10on/xiao-camera-remote/docs/design/ux-redesign.md

> **Repo note (2026-08-27).** This is the **authoritative UI/UX specification**
> for the remote, built from real shooting experience. Where it conflicts with
> the screen handoff (`screen-handoff-readme.md`, `Remote Screen.dc.html`) or
> with the "Профили" model of `filming-remote-requirements-v14.md` §3, **this
> document wins.** What it does *not* change: the handoff's colour system,
> typography, and panel geometry still stand — this document replaces the screen
> *model* and *flow*, not the visual language. Implementation status and the gap
> versus current firmware are tracked in `docs/screen-design.md`.

# Пульт съёмочной техники: UX-спецификация переработки

Статус: черновик требований к новой UX-модели.  
Основание: текущая прошивка и экранная логика `Pult UI Logic`.

## 1. Зачем меняем

Пульт должен быть инструментом для начала съёмки, а не интерфейсом для ручного включения отдельных Bluetooth-устройств. Обычный сценарий выглядит так:

1. Пользователь собирает риг: например, ставит телефон на слайдер и включает оба устройства.
2. Включает пульт.
3. Одним действием выбирает съёмочную конфигурацию либо запускает последнюю.
4. Пульт сам подключает нужные устройства и сразу открывает управление главным устройством.
5. Пользователь двигает слайдер/тележку и запускает или останавливает запись с пульта.

Текущий экран Device List не должен быть стартовой точкой обычной работы. Он полезен для настройки и диагностики, но не для каждого съёмочного дубля.

## 2. Цели и границы

### Цели

- Убрать необходимость вручную включать каждое устройство перед началом съёмки.
- Сделать стартовый путь понятным без чтения подсказок: «выбрал риг → дождался подключения → снимаю».
- Всегда показывать органы управления того устройства, которое сейчас является главным для кадра.
- Оставить телефон вспомогательным устройством записи: он не должен занимать основной экран, пока в конфигурации есть слайдер или тележка.
- Поддержать один или несколько телефонов в одной конфигурации.
- Сохранить безопасность: экстренная остановка должна быть доступна из любого активного экрана.
- Не усложнять сейчас случай нескольких главных устройств; заложить модель так, чтобы его можно было добавить позже.

### Пока не входит в объём

- Одновременное полноценное управление несколькими главными устройствами на одном экране.
- Редактор сложных сценариев/таймлайнов движения.
- Автоматическое определение физически ближайшего устройства без предварительной регистрации.

## 3. Термины и модель

| Термин | Значение |
| --- | --- |
| Устройство | Зарегистрированный BLE-участник: Slider, Dolly, Phone #1, Phone #2 и т. п. |
| Тип устройства | Категория с собственным интерфейсом и набором команд: Motion, Camera/Phone, в будущем Light и др. |
| Главный участник (Main) | Не более одного на первом этапе. Определяет главный экран управления и основной набор команд. Обычно Slider или Dolly. |
| Вспомогательный участник (Secondary) | Устройство, которое участвует в съёмке, но не определяет главный экран. Телефон — типичный пример. |
| Съёмочная конфигурация | Сохранённый набор ролей и устройств: один Main (необязательно) и ноль или больше Secondary. Ранее — «профиль». |
| Быстрый набор | Предустановленная или сохранённая съёмочная конфигурация, доступная на стартовом экране. |
| Сессия | Текущий запущенный набор подключений и его состояние. |
| Дубль (Take) | Период между запуском и остановкой записи; при наличии Main может также запускать/останавливать его движение. |

### Инварианты

- Устройство нельзя одновременно назначить Main и Secondary в одной конфигурации.
- На первом этапе в конфигурации максимум один Main.
- Телефонов может быть несколько, и все они имеют роль Secondary.
- Конфигурация без Main допустима: например, `Два телефона`. В ней открывается простой экран записи.
- Конфигурация с Main, но без телефона, допустима: запись просто недоступна, а пульт управляет движением.
- Незарегистрированные или не входящие в конфигурацию устройства не подключаются во время этой сессии.

## 4. Автоподключение и регистрация

### Обычная работа

После запуска конфигурации пульт сам ищет и подключает только её участников. Пользователь не выбирает Slider, Phone или Dolly по одному и не подтверждает каждое подключение.

На стартовом экране выбранной по умолчанию должна быть последняя использованная конфигурация. Нажатие `OK` запускает её сразу. Остальные популярные конфигурации остаются видны ниже и выбираются стрелками. Это даёт быстрый запуск привычного рига, но не заставляет пульт подключаться к старому набору, если сегодня собрана другая техника.

Отдельная настройка `Автозапуск последней конфигурации` может убрать и это единственное нажатие; по умолчанию она выключена.

### Первый раз и обслуживание

У пульта должен остаться отдельный раздел `Устройства`:

- добавить новое устройство в реестр;
- дать ему понятное имя: `Телефон Дениса`, `Телефон B`, `Слайдер`, `Тележка`;
- увидеть тип, идентификатор и состояние последнего соединения;
- удалить или переименовать устройство;
- проверить соединение вручную.

Это не часть ежедневного сценария. Если устройство уже зарегистрировано и включено, конфигурация подключит его автоматически.

### Ошибки подключения

- Подключение Main важно для основной работы; пока его нет, доступна отмена и экран статуса, но управление движением не имитируется.
- Отсутствующий телефон не должен блокировать управление Main. На экране явно показывается `Запись недоступна: Phone #1 не подключён`.
- При потере Main во время дубля пульт немедленно отправляет аварийную остановку всем ещё доступным Motion-устройствам и завершает состояние дубля.
- При потере телефона во время дубля пульт показывает заметный, но не полноэкранно блокирующий статус; остальные устройства продолжают работать. Если телефон переподключился, он возвращается в сессию.
- Полноэкранное блокирующее сообщение допустимо только при отсутствии или потере Main вне режима дубля.

## 5. Стартовый экран: «Конфигурации»

Это новый домашний экран вместо Device List.

Содержимое:

- заголовок `Конфигурации`, индикатор батареи и общий BLE-статус;
- 3–5 быстрых наборов, прокручиваемых стрелками;
- у каждого набора — название, иконки/краткий состав и последнее состояние;
- первым и выделенным — последний использованный набор;
- внизу постоянные подсказки: `OK — подключить`, `→ — изменить`, `удерживать ← — устройства/настройки`.

Начальные наборы:

| Название | Main | Secondary | Назначение |
| --- | --- | --- | --- |
| Slider + Phone | Slider | Phone #1 | Обычная съёмка телефона на слайдере |
| Dolly + Phone | Dolly | Phone #1 | Съёмка с тележкой |
| Slider | Slider | — | Ручная работа без записи |
| Dolly | Dolly | — | Ручная работа с тележкой |
| Phones | — | Phone #1, Phone #2 | Одновременный запуск/остановка камер |

Наборы — это данные, а не зашитые экраны: пользователь может переименовать, создать копию, изменить состав и удалить пользовательский набор.

## 6. Экран подключения

После `OK` стартовый экран не исчезает мгновенно, а превращается в короткий статус запуска с тем же названием набора.

Для каждого участника показываются состояния: `ищу`, `подключается`, `готов`, `нет связи`. Main отделён визуально от Secondary.

Правила перехода:

- когда Main готов — автоматически открыть экран управления; подключение Secondary продолжается в фоне;
- для набора без Main открыть экран записи, когда готов хотя бы один Phone;
- если за разумный таймаут не готов ни один требуемый участник, оставить экран статуса с действиями `OK — повторить`, `удерживать ← — отменить`;
- повторное открытие конфигурации не должно создавать дублирующие BLE-подключения.

## 7. Главный экран управления

### Общий принцип

Экран строится вокруг Main. То есть `Slider + Phone` выглядит как управление слайдером с компактным блоком записи, а `Dolly + Phone` — как управление тележкой с тем же блоком записи. Пользователь не переключается на экран телефона ради одной команды затвора.

### Общий каркас

- Верхняя строка: имя конфигурации, состояние Main и компактные индикаторы Secondary.
- Центральная часть: модель/параметры Main и его главные действия.
- Нижняя часть: явное действие `REC`/`STOP REC` и короткая подсказка клавиш.
- Проблемы соединения показываются в статусной зоне и не закрывают органы управления без необходимости.

### Slider

На первом экране слайдера должны быть видны минимум:

- выбранная программа слайдера; по умолчанию — `Ping-Pong`;
- подтверждённое слайдером состояние программы: стоит / выполняется / ошибка;
- публичные параметры программы: скорость и стартовая точка;
- явное действие `START / STOP`;
- состояние телефонов: сколько из выбранных камер готово к записи.

Обычный экран не реализует Ping-Pong локальной последовательностью команд направления.
Пульт выбирает, настраивает и запускает готовую программу через Program characteristic,
а состояние отображает только после notify от слайдера. При подключении отправляется
`SELECT Ping-Pong` без перезаписи сохранённых на слайдере параметров.

Ручные `F/B`, абсолютная позиция, ток и homing остаются отдельным экраном
`Advanced / Service`. Перед переходом туда пульт останавливает активную программу. Это
не позволяет случайно смешать состояние preset с ручным jog.

### Dolly

Экран тележки показывает направление, скорость, состояние движения и доступность аварийной остановки. Использует свой набор команд, включая `E-Stop`; у тележки не показывается недоступная команда Home.

### Набор без Main

Для набора из телефонов главный экран — компактная панель камер: сколько подключено, запись идёт/не идёт, таймер дубля и действие `REC`/`STOP`. Никакого пустого «экрана устройства».

## 8. Запись и дубль

### Базовое действие

`OK` на главном экране должно быть однозначно подписано:

- если готов хотя бы один Phone и дубль не идёт — `REC`;
- если дубль идёт — `STOP REC`;
- если телефонов нет или они не готовы — кнопка выполняет основное действие Main только тогда, когда оно явно подписано; она не должна молча начинать движение под видом записи.

При нескольких телефонах `REC` и `STOP REC` рассылаются всем готовым телефонам. Результат показывается по каждому: например, `2/2 REC` или `1/2 REC, Phone B нет связи`.

### Движение во время дубля

Старый неявный жест «OK одновременно включает запись и отправляет MoveForward» заменяется явной политикой дубля в конфигурации:

- `Запись`: `OK` управляет только телефонами;
- `Запись + движение Main`: `OK` запускает запись и выбранную готовую программу Main;
- `Ручное движение`: доступно отдельно в Advanced, независимо от записи.

Для первого релиза конфигурации `Slider + Phone` используется режим `Запись`: `OK`
управляет только записью, а запуск выбранной программы остаётся отдельным явно
подписанным действием `START / STOP`. Комбинированный режим можно включить в параметрах
набора, когда действие `REC + START PING-PONG` явно обозначено на экране.

### Экран/состояние дубля

Во время записи главный экран не заменяется другой логикой полностью. Он сохраняет управление Main, но получает заметный режим дубля: красный REC-индикатор, таймер, число активных камер и доступное действие `STOP REC`.

Долгое `OK` — безусловная аварийная команда: остановить движение Main и отправить `StopRecord` всем подключённым телефонам. Она работает независимо от текущего экрана внутри активной сессии.

## 9. Редактирование конфигурации

Переход: на стартовом экране выбрать набор → `→` → `Изменить`.

Редактор создаёт или меняет конфигурацию последовательными шагами:

1. Название.
2. Main: `нет`, `Slider`, `Dolly`; затем выбор конкретного зарегистрированного экземпляра.
3. Secondary: список зарегистрированных устройств с чекбоксами. Телефонов можно выбрать несколько.
4. Поведение дубля: `Запись` или `Запись + движение Main`.
5. Применить и сохранить.

Если выбран Main, он показывается в сводке отдельно и первым. Список Secondary не должен пытаться навязать пользователю «главное устройство» через порядок строк.

## 10. Навигация и кнопки

Оставляем пять физических кнопок и правило долгого нажатия как возврата/аварийного действия, но делаем их роль предсказуемой по контексту.

| Экран | ↑ / ↓ | ← / → | OK | Удержание OK | Удержание ← |
| --- | --- | --- | --- | --- | --- |
| Конфигурации | выбор | изменить/детали | запустить набор | — | устройства и настройки |
| Подключение | — | — | повторить при ошибке | — | отменить сессию |
| Управление Slider | параметры выбранной программы | параметры выбранной программы | START/STOP или REC/STOP REC согласно явно показанному режиму | E-Stop + StopRecord | выйти к конфигурациям |
| Advanced Slider / Dolly | ручная команда или скорость согласно подсказке | ручная команда или скорость согласно подсказке | подтвердить | E-Stop | назад к программе |
| Управление Phones | — | — | REC / STOP REC | StopRecord | выйти к конфигурациям |
| Редактор | выбор поля | изменить значение/следующий шаг | подтвердить | — | назад без сохранения |

`←` и `→` не обязаны всегда значить одно и то же, но на любом экране должна быть нижняя подсказка. В рабочем экране они никогда не должны случайно открывать меню или менять состав устройств.

## 11. Настройки и технические экраны

Текущие `Brightness` и `OTA update` остаются в настройках. Разделы предлагаются такие:

- `Конфигурации` — создание и изменение быстрых наборов;
- `Устройства` — регистрация, диагностика, переименование;
- `Управление` — биндинг осей, скорости и безопасные настройки;
- `Экран` — яркость, сон;
- `Система` — OTA, версия прошивки.

Старый Device List становится подразделом `Устройства` и диагностическим экраном, а не экраном, на который возвращается каждый `hold ←`.

## 12. Состояния, которые обязаны быть видимы

1. Конфигурация выбрана, но ещё не запущена.
2. Идёт поиск/подключение конкретного устройства.
3. Main готов, Secondary ещё подключаются.
4. Main работает, запись недоступна из-за отсутствующего телефона.
5. Идёт дубль: таймер, камеры, движение Main.
6. Один из нескольких телефонов потерян во время дубля.
7. Main потерян или аварийно остановлен.
8. Конфигурация без Main: камеры только для записи.

Для каждого состояния пользователь должен видеть, что работает сейчас, чего не хватает и какая следующая доступная команда. Сообщения не должны требовать догадки о том, какой именно Bluetooth-статус скрывается за точками или цветом.

## 13. Отложенное расширение: несколько Main

Модель допускает `mainDevices[]`, но интерфейс первого релиза использует только `mainDevice` или `null`. Когда появится второй Main, не следует просто смешивать все кнопки. Нужны отдельные правила: активный Main, объединённый виджет или отдельный режим синхронного дубля. До этого момента редактор не позволяет выбрать больше одного Main.

## 14. Критерии готовности первого релиза

- С выключенного пульта сценарий `Slider + Phone` запускается максимум двумя действиями: включить пульт, нажать `OK` на последнем наборе.
- Пользователь не выбирает отдельные устройства вручную для обычной съёмки.
- После готовности слайдера пульт открывает управление им, не ожидая телефон бесконечно.
- На экране `Slider + Phone` пользователь одновременно видит доступность записи и состояние слайдера.
- `OK` никогда не запускает скрытое движение, если надпись на экране обещает только запись.
- Основной экран Slider управляет готовым Ping-Pong через Program API; `F/B` доступны
  только в явно обозначенном Advanced режиме.
- После BLE write UI не меняет состояние программы сам: `RUNNING`, параметры и ошибки
  подтверждаются Program notify.
- При двух телефонах старт и остановка записи отправляются обоим, а частичный сбой понятен по экрану.
- Долгое `OK` останавливает все доступные Motion-устройства и запись на всех доступных телефонах.
- Пользователь может создать набор без Main и набор без телефона.
- Список устройств, OTA и яркость остаются доступны, но не мешают ежедневному запуску съёмки.

## 15. Решения, которые можно принять позже

- Нужен ли по умолчанию режим `Запись + движение Main` для каких-то конкретных ригов.
- Нужно ли делать автозапуск последней конфигурации включённым по умолчанию после нескольких успешных использований.
- Какие именно данные Slider и Dolly способны отдать для экрана: скорость, направление, позиция, заряд, состояние команды.
- Как именно обозначить связь с конкретными телефонами: пользовательское имя, номер, цвет или иконка.
- Нужен ли быстрый режим временно добавить устройство к текущей сессии без сохранения конфигурации.

---

## Приложение: сведение с остальными документами репозитория (2026-08-27)

Не входит в исходный документ — добавлено при переносе в репозиторий. Исходный
текст выше не менялся.

### Что этот документ заменяет

- **`screen-handoff-readme.md` / `Remote Screen.dc.html`, список из 7 экранов.**
  Домашний экран больше не «Main / device status», а «Конфигурации». Появляются
  новые экраны: подключение, Main-центричное управление, редактор конфигурации,
  реестр устройств. Device List превращается в диагностический подраздел
  `Устройства`. Цвета, типографика и геометрия из handoff остаются в силе —
  меняется модель и поток экранов, не визуальный язык.
- **`filming-remote-requirements-v14.md` §3 «Профили».** Модель
  `Profile { name, devices, bindings[input→targets[]] }` с редактором биндингов
  заменяется ролевой моделью: `Config { name, main?, secondary[], takeMode }`.
  Fan-out одной кнопки (кейс «интервью»: центр = запись + старт слайдера)
  сохраняется, но выражается режимом дубля `Запись + движение Main`, а не
  произвольным массивом `targets`. Биндинг осей (скорость на ↑↓ / ←→) становится
  глобальной настройкой в разделе `Управление`, а не полем профиля.

### Что остаётся из v14 и должно сосуществовать с новым потоком

- Аварийный стоп = долгое нажатие центральной кнопки → широковещательный
  `StopAll` в обход конфигурации (v14 §9). Совпадает с §8/§10 этого документа.
- Watchdog на стороне моторного устройства (~2 сек без команды → само
  останавливается, v14 §9) дополняет pult-side аварийную остановку из §4.
- Deep sleep как дефолтное состояние покоя, «первое нажатие после сна только
  будит, не выполняет команду», суточная проверка заряда (v14 §7) — этот
  документ их не отменяет и не упоминает.
- Индикация записи на телефоне — «команда отправлена», не «идёт запись»
  (v14 §2, HID односторонний). REC-индикатор и таймер из §8 трактуются как
  состояние **дубля** (pult-side период старт→стоп) и статус доставки команды
  (`2/2 REC`), а не как подтверждённый факт съёмки. Копирайт на экране держать
  в этих терминах.

### Технические риски, которые ставит новая модель

- **Несколько телефонов одновременно.** Пульт — BLE HID peripheral; несколько
  телефонов = несколько центральных хостов на одном HID-устройстве. HID-over-GATT
  обычно завязан на один забонженный хост. Проверить на макете до того, как
  `Phones` станет обещанной конфигурацией.
- **Автоподключение только участников конфигурации.** `BleManager` держит один
  общий скан и реконнектит все активные устройства (см. `src/ble_manager.*`);
  «активность» теперь задаёт конфигурация, а не ручной тоггл в Device List.

### Пиксельный мок и статус реализации (2026-08-28)

Полный экранный мок под эти требования — `docs/design/ux-redesign-mock/`
(`new-model.dc.html`, 24 экрана 280×240 в палитре `src/theme.h`). Реализован
целиком на ветке `ux-redesign-rigs` (собирается, на железе не проверялся).
Копирайт — английские заглушки: кириллического `GFXfont` в прошивке нет,
это отдельный заход. Подробная карта «экран мока → код» — в
`docs/screen-design.md`.

Ключевые изменения кода:

- `src/menu.*` разбит: `menu.cpp` (конечный автомат + ввод), `menu_render.cpp`
  (все `render*`), `menu_internal.h` (общие хелперы риг/сессии). Экраны:
  `Rigs, RigMenu, Editor, TextEntry, Connecting, Control, Settings, Devices,
  DeviceCard, Scan, ControlPrefs, ScreenPrefs, System`.
- Неявный комбо-жест `comboModeActive()` удалён — заменён явным `Rig::takeMode`
  (по умолчанию `RecordOnly`).
- `src/profile.{h,cpp}` → `src/rig.{h,cpp}`: `Rig` — мутабельная структура
  (имя, `mainIndex`, `secondary[4]`, `takeMode`). `src/rig_store.*` — NVS-blob
  с версией, сидит дефолты из §5, CRUD для редактора.
- `src/device_table.*` — стабильная нумерация устройств (`deviceAt`/
  `deviceCount`/`deviceIndexOf`), на которую ссылаются риги.
- `src/device_registry.*` — алиас устройства (NVS) + грубый `SeenState`.
- `Device`: `kind()`, `supportsHome()`, `speedPercent()` (1..100%; была пара
  `speedLevel()`/`speedLevelMax()` с шкалой 1..8 — 2026-08-29 перешли на проценты,
  родную единицу слайдера, см. `docs/screen-design.md` строка 4).
- `src/settings.*`: `axisBinding`, `autostartLastRig`, `maxSpeedPercent`,
  `buttonSound`, `factoryReset()`; старые ключи `profile`/`binding` брошены,
  `maxspd` → `maxspdpct`.

Отложено: несколько телефонов (риг `Phones` пока цепляет один); настоящая
регистрация устройства с экрана `Scan` (нужны динамические драйверы);
драйвер столика; отдельный экран батареи; сон в разделе «Экран»; иконки-
пиктограммы устройств (в чипах пока 2-буквенный `abbrev()`).
