10on/xiao-camera-remote/docs/design/requirements-v4.md

# Съёмочный пульт — требования (v4, итоговый черновик)

**Обновлён:** 2026-08-20
**Изменение к v3:** плата защиты аккумулятора (1S DW01A+8205A) заказана — статус закрыт, под неё зарезервировано место в корпусе.

Легенда: ✅ зафиксировано · 🟡 предварительно · ❓ открыто · ⚠️ риск/замечание

---

## 1. Назначение

Компактный автономный BLE-пульт для управления съёмочной техникой во время съёмки. Физический контроллер текущего сетапа, а не touchscreen-remote. Основные операции — вслепую, одной рукой.

✅ Пульт универсальный, не приставка к слайдеру.

---

## 2. Управляемые устройства

| Устройство | Роль | Протокол | Статус |
|---|---|---|---|
| Смартфон | старт/стоп записи | ✅ **BLE HID** — эмуляция BT-кнопки-гарнитуры (как ali-shutter) | решено |
| Самодельный слайдер | движение, старт/стоп, позиции | ✅ свой BLE GATT, протокол дорабатываем под пульт | решено |
| Коммерческая тележка | движение | ✅ **есть официальный API и документация** | решено, риск снят |
| **Предметный столик** | вращение: старт/стоп, скорость, направление, угол/шаг | ✅ **свой протокол** (проектируется вместе с пультом) | заложить в архитектуру |
| Свет | — | — | ❌ **вне скоупа**, вернуться если появятся устройства |

### Предметный столик

✅ Свой протокол — как и у слайдера, значит проектируется под пульт, а не реверсится.

🟡 **Рекомендация: сделать слайдер и столик одним семейством протокола**, а не двумя разными. Оба — «моторизованная ось»: старт/стоп, скорость, направление, позиция, home, лимиты. Разница только в том, что у слайдера ось линейная, а у столика — вращательная и бесконечная (нет концевиков, позиция циклическая).

Что это даёт: один драйвер `MotionAxisDriver` вместо двух, одинаковые команды с пульта, общий код прошивки на обоих устройствах. При добавлении третьей моторизованной штуки (слайдер по второй оси, поворотная голова) — драйвер уже готов.

Что заложить в общий протокол:
- `axis_type`: linear / rotary
- для rotary: позиция в градусах, «бесконечное» вращение как отдельный режим
- у столика типовой сценарий — **непрерывное вращение с заданной скоростью** и **пошаговое вращение** (N градусов на кадр, для покадровой съёмки). Второе стоит заложить сразу.

❓ Есть ли у столика концевик / точка home. Для повторяемых съёмок «начать с той же стороны» это полезно.

### ⚠️ Ключевое следствие: пульт должен быть BLE dual-role

- к **телефону** — как **peripheral** (HID-устройство, телефон видит его как кнопку/гарнитуру);
- к **слайдеру и тележке** — как **central** (пульт сам подключается к ним).

Одновременно. ESP32 это умеет (NimBLE, роли central+peripheral в одном стеке), но это надо заложить в архитектуру с самого начала, а не прикручивать потом. В конфиге NimBLE явно задаются `MAX_CONNECTIONS` и обе роли.

### ⚠️ Ограничение HID-подхода к телефону

Эмуляция кнопки гарнитуры (обычно Volume Up / Enter) — это **односторонняя команда без обратной связи**:

- пульт не знает, идёт ли запись на самом деле;
- работает только если приложение камеры на переднем плане;
- на iPhone поведение отличается от Android.

**Следствие:** светодиод «идёт запись» для телефона показывает **намерение**, а не факт. Либо честно индицировать «команда отправлена», либо в будущем делать приложение-компаньон. ❓ Решить, как это отражать в UI.

### Слайдер

✅ На слайдере есть **две физические кнопки**.
✅ Протокол слайдера **можно дорабатывать** под нужды пульта — это не чужой чёрный ящик.
❓ Арбитраж: что делает слайдер, если команда пришла и с кнопки, и с пульта. Приоритет? Последний победил?

---

## 3. Профили

✅ **Профили нужны** (изменение относительно первой версии требований, где от них отказывались).

Профиль = именованный набор устройств сетапа, который можно быстро выбрать.

Требования:
- создать/переименовать/удалить профиль;
- профиль хранит список устройств (адреса + тип драйвера) и, возможно, их роли/маппинг кнопок;
- быстрое переключение профиля с пульта;
- хранение в NVS (переживает перезагрузку);
- 🟡 3–8 профилей достаточно.

### ✅ Маппинг кнопок хранится в профиле

Решено: **маппинг может отличаться от профиля к профилю**. Профиль — это не просто список устройств, а полная раскладка сетапа.

Структура профиля:

```
Profile {
  name: string
  devices: [ { addr, driver_type, alias } ]
  bindings: [
    { input: Btn.Up | Btn.Down | Btn.Left | Btn.Right | Btn.Center,
      gesture: Short | Long | Double,
      targets: [ { device_idx, command, params } ] }
  ]
}
```

Следствия, которые надо учесть:

- **Один input → массив targets.** Это то, что даёт fan-out: центральная кнопка в профиле «интервью» = запись на телефоне + старт слайдера одновременно.
- **Нужен редактор биндингов.** На экране 240×280 и пятью кнопками редактировать раскладку — мучение. 🟡 Предлагаю: на пульте только выбор из **пресетов раскладки** («слайдер+телефон», «столик+телефон», «только запись»), а произвольное редактирование — позже и не с пульта (веб-морда в OTA-режиме или конфиг-файл).
- **Устройство в профиле может быть офлайн.** Биндинги на него должны деградировать молча, а не ломать профиль.
- **Дефолтные биндинги на тип драйвера.** При добавлении устройства в профиль сразу подставляется разумная раскладка для его типа, дальше правится. Иначе каждый новый профиль надо собирать с нуля.

25 комбинаций (5 кнопок × 3 жеста, минус занятое под навигацию) — этого хватает с запасом.

---

## 4. Органы управления

✅ **5 физических кнопок, крестом (↑ ↓ ← → + центр).**
✅ Центральная кнопка пока такая же, как остальные; возможность переработки (крупнее/другая форма) заложить в корпус, но не делать сейчас.
✅ Microtact на PCB + напечатанные толкатели.
✅ Пригодность к работе вслепую.

### Модификаторы

Раз кнопок всего 5, а устройств 2–3, нужны:
- долгое нажатие;
- двойное нажатие;
- комбинации (например ● + ↑).

⚠️ Комбинации **не работают**, если кнопки повешены на резистивную ADC-лесенку (см. §11). Если комбинации нужны — только расширитель портов или отдельные GPIO.

---

## 5. Индикация

✅ Индицировать нужно **4 состояния**:
1. зарядка
2. идёт запись / активное действие
3. потеря связи с устройством
4. низкий заряд

✅ Реализация: 2–3 обычных светодиода **или RGB**.
✅ Допустимо вешать через расширитель портов (либо на расширитель уходят кнопки, а LED на GPIO).

🟡 **Рекомендация: 1–2 адресных WS2812 вместо дискретных LED.**

Почему: один GPIO вместо трёх, любой цвет и яркость программно, четыре состояния кодируются цветом + миганием, а не количеством диодов. Учитывая дефицит пинов (§11) — это самый дешёвый по пинам вариант. Минус: WS2812 ест ~1 мА даже погашенный, и есть паразитная подсветка корпуса. При двух диодах: один «система» (зарядка/батарея), один «связь/запись».

⚠️ Через PCF8574 **нельзя** сделать плавную яркость — только вкл/выкл. Для RGB на расширителе это значит 7 фиксированных цветов, без затухания.

---

## 6. Дисплей

✅ **Waveshare TFT 1.5" 240×280 IPS**, контроллер ST7789V3, SPI.
✅ Ориентация **горизонтальная**.
✅ **Управление яркостью обязательно** → пин BL должен идти на GPIO с аппаратным PWM (LEDC), **не через расширитель**.

Память: 240×280×16 бит = **131 КБ** на полный кадровый буфер.
- На XIAO ESP32-S3 с PSRAM это некритично.
- Правильнее LVGL с частичными буферами (1/10 экрана ≈ 13 КБ) — тогда хватает и внутренней RAM.
- ✅ Внешние модули памяти есть в наличии, если понадобятся — но, скорее всего, не понадобятся.

---

## 7. Энергосбережение

✅ **Основной механизм — управление яркостью подсветки.**
- при пробуждении подсветка на рабочем уровне;
- после бездействия — гаснет (или уходит в dim);
- BLE-соединения при этом **не рвутся**;
- любая кнопка возвращает подсветку, первое нажатие только будит и **не выполняет команду** ❓ (или всё-таки выполняет? для съёмки может быть критично не терять нажатие).

✅ Deep sleep всего МК **не используется** между командами.
✅ Wi-Fi **выключен по умолчанию**, включается только в отдельных функциях.

---

## 8. Wi-Fi и OTA

✅ Wi-Fi нужен **только под OTA**. Других функций пока нет.
✅ Реализация: **отдельный пункт меню**, который:
1. включает Wi-Fi,
2. переводит пульт в режим ожидания прошивки,
3. показывает на экране статус/IP,
4. по выходу или таймауту гасит Wi-Fi обратно.

✅ **OTA — эксклюзивный режим.** Пока он активен, остальные функции недоступны: BLE отключается, соединения с устройствами рвутся, кнопки работают только на выход из режима. На экране — статус и способ выхода.

Почему это правильно: снимает конкуренцию Wi-Fi и BLE за радио (у ESP32 они делят антенну и время), убирает риск «начали прошивку, а в этот момент кто-то нажал старт слайдера», и упрощает состояние прошивки — не надо поддерживать работу драйверов во время обновления.

❓ Способ доставки: ArduinoOTA / web-uploader / ESP-IDF OTA по HTTP.
🟡 Если делать web-uploader — та же веб-морда пригодится для редактирования профилей и биндингов (§3).

---

## 9. Программная архитектура

✅ Интерфейс пульта не зависит от протокола устройства. Кнопка означает `Record`, `StartMove`, `Stop`; в конкретный пакет это превращает драйвер устройства.

```
[5 кнопок] → [Input/Gestures] → [UI/State] → [Command Bus] ─┬→ [PhoneDriver]  → BLE HID (peripheral)
                                    ↑                       ├→ [SliderDriver] → BLE GATT (central)
                              [ProfileStore/NVS]            └→ [DollyDriver]  → BLE API (central)
```

Требования:
- независимые драйверы на тип устройства;
- список обнаруженных устройств + сохранение известных;
- профили (§3);
- автоматический реконнект;
- отображение состояния соединений;
- fan-out одной команды на несколько устройств.

---

## 10. Корпус

✅ 3D-печатный, компактный, в руке и в кармане, яркий цвет.
✅ **USB-C от XIAO выведен наружу** и служит портом зарядки → плата должна стоять так, чтобы разъём попадал в стенку корпуса (логично — низ).
✅ Толкатели кнопок — часть корпуса.
✅ Зарезервировано место под плату защиты аккумулятора (~30×4 мм, между пакетом и XIAO — физически рядом с батарейным отсеком).
🟡 Габариты порядка 42 × 85–100 × 16–20 мм.
🟡 Аккумуляторы внизу для развесовки.
❓ Крепление: темляк / клипса / липучка.

---

## 11. Аппаратная платформа

### МК

✅ **XIAO ESP32** (4 шт XIAO ESP32-S3 в наличии).
❓ Уточнить вариант: S3, C3 или C6. Рекомендация — **S3**: PSRAM под графику, больше GPIO, и их у тебя 4 штуки.

### ⚠️ Дефицит пинов — главная нерешённая инженерная задача

XIAO ESP32-S3 выводит **11 GPIO (D0–D10)**. Считаем:

| Потребитель | Пинов |
|---|---|
| Дисплей SPI: SCK, MOSI, CS, DC | 4 |
| Дисплей RST | 1 (можно сэкономить — RC-цепочка на питание) |
| Дисплей BL (PWM, обязательно GPIO) | 1 |
| Замер напряжения батареи (ADC + делитель) | 1 |
| 5 кнопок | 5 |
| Индикация | 1 (WS2812) или 3 (дискретные LED) |
| **Итого без расширителя** | **13–15 → не влезает** |

Варианты решения:

**A. PCF8574 на кнопки** (он уже есть, использовался в слайдере)
`SDA + SCL + INT = 3 пина` дают 8 входов.
Итого: 4 SPI + 1 RST + 1 BL + 1 ADC + 3 I2C + 1 WS2812 = **11**. Впритык, ноль запаса.
Убрав RST через RC → 10, один пин в резерве. ✅ Комбинации кнопок работают.

**B. Резистивная ADC-лесенка на 5 кнопок = 1 пин**
Итого: 4 + 1 + 1 + 1 + 1 + 1 = **9**, два пина в запасе.
⚠️ Но: **не читаются комбинации** (одновременные нажатия) — а они нужны при 5 кнопках (§4). Плюс сложнее дребезг.

**C. Расширитель на кнопки И на LED**
Второй PCF8574 по тому же I2C, +0 пинов. Но яркость LED не порулить.

✅ **Решено: вариант A — расширитель портов.** Кнопки на PCF8574 (SDA/SCL/INT), индикация на WS2812, RST дисплея через RC. Комбинации кнопок сохраняются, один пин в резерве.

Замечания по реализации:
- ⚠️ **Обязательно использовать пин INT.** Без него придётся опрашивать расширитель в цикле — это добавляет задержку нажатия и постоянный I2C-трафик. INT даёт прерывание по любому изменению входов, дальше одно чтение по I2C.
- PCF8574 — это квазидвунаправленные пины: для чтения кнопки пин надо держать в 1, кнопка замыкает на землю. Подтяжка внутренняя слабая (~100 мкА) — при длинных проводах ловит наводки, лучше добавить внешние 10 кОм.
- Дребезг обрабатывать в прошивке, конденсаторы на кнопки не нужны.
- Свободных входов на расширителе останется 3 — туда же можно повесить резервные кнопки или переключатель питания, если появятся.
- ❓ Адрес: PCF8574 (0x20–0x27) vs PCF8574A (0x38–0x3F). Если когда-нибудь понадобится второй расширитель — сразу планировать разные адреса.

### Питание

✅ **Два Li-Po по 500 мАч** из электронных сигарет, параллельно = 1000 мАч.
✅ Зарядка — **встроенным контроллером XIAO**, USB-C с платы наружу.
🟡 Если по факту мало — заранее посмотреть ячейку побольше (место в корпусе закладывать с запасом).

⚠️ **Проверить ток заряда XIAO.** У XIAO ESP32-S3 заряд по умолчанию ~100 мА (задаётся резистором на плате). Для пакета 1000 мАч это **~10–12 часов** полной зарядки. Если не устраивает — либо менять резистор, либо внешний зарядник.

⚠️ **Нужна защитная плата на пакет — но не «BMS» в смысле балансировки.**

XIAO закрывает **только заряд**: контроллер BQ25101 корректно ведёт CC/CV и завершает зарядку. Балансировка тут действительно не нужна — банка одна (1S).

Чего XIAO **не делает**:

| Угроза | Прикрывает ли XIAO |
|---|---|
| Перезаряд выше 4.2 В | ✅ да, это работа зарядного чипа |
| **Переразряд ниже 3.0 В** | ❌ **нет** |
| **КЗ на выходе** | ❌ нет |
| Отказ самого зарядного чипа | ❌ нет резервирования |

**Переразряд — главная причина.** На плате нет отсечки по нижнему порогу: ESP32 тянет ток с ячейки, пока LDO не уйдёт в brownout (~3.0 В), а после brownout утечки продолжаются — расширитель, WS2812, сам МК в остаточном режиме. Пульт, забытый в сумке на месяц, придёт к 0 В.

Ниже ~2.5 В в Li-Po начинается растворение медного токосъёмника и рост дендритов. Ячейка после этого выглядит живой и заряжается, но при следующем цикле даёт внутреннее замыкание. Именно это, а не перезаряд, чаще всего и приводит к возгоранию.

**Ячейки из электронок идут голыми** — в вейпе защиту обеспечивает его собственная плата, на самой банке её нет. В отличие от «защищённых» 18650, где схема приклеена к торцу.

✅ **Заказана плата 1S DW01A+8205A** (~30×4 мм). Ставится одна на весь параллельный пакет, между пакетом и XIAO. Даёт отсечку по переразряду (~2.4 В), по перезаряду (~4.3 В, второй эшелон поверх зарядки XIAO) и по КЗ.

✅ **В корпусе зарезервировано место под плату** — закладывать в разводку компоновки сразу, а не по факту получения посылки.

До прибытия платы работаем на связке «аппаратный выключатель + софтовая отсечка в прошивке» — этого достаточно для макета и первых тестовых съёмок. Мягкая отсечка (выключаться при 3.3 В по замеру ADC) остаётся основным механизмом и после установки платы защиты: плата — последний рубеж на случай зависшей прошивки или забытого включённым пульта, а не замена программной логики.

⚠️ **Параллелить только одинаковые ячейки одного возраста**, и соединять их предварительно уравняв напряжение.

⚠️ **Замер батареи.** У XIAO ESP32-S3 нет разведённого делителя на ADC — придётся вешать свой (2 резистора) на отдельный пин, он учтён в бюджете выше.

---

## 12. Что осталось открытым

1. Вариант XIAO: S3 / C3 / C6
2. Индикация: WS2812 vs дискретные LED
3. Есть ли у предметного столика home/концевик
4. Объединять ли слайдер и столик в один протокол моторизованной оси
5. Редактор биндингов: пресеты на пульте + веб-морда, или что-то другое
6. Первое нажатие при погашенном экране — будит или выполняет команду
7. Арбитраж «кнопки на слайдере vs пульт»
8. Как честно индицировать запись на телефоне при отсутствии обратной связи
9. Способ доставки OTA
10. Крепление пульта
11. Целевая задержка от нажатия до BLE-команды (предложение: <100 мс)
12. Поведение при потере связи в середине проезда (слайдер продолжает? watchdog-стоп?)
13. Аварийный стоп — отдельный жест или комбинация
14. Адрес PCF8574 vs PCF8574A

**Закрыт в этой версии:** защита аккумулятора — плата 1S DW01A+8205A заказана, место в корпусе зарезервировано (§10, §11).

---

## 13. Первые шаги реализации

Порядок, минимизирующий переделки:

1. **Макет на столе:** XIAO S3 + дисплей по SPI + PCF8574 с 5 кнопками. Проверить, что 240×280 рисуется с приемлемым FPS и что хватает RAM.
2. **BLE dual-role skeleton:** одновременно HID-peripheral к телефону и central к одному тестовому устройству. Это самая рискованная часть — проверить до разводки платы.
3. **HID-эмуляция кнопки записи** на своём телефоне — убедиться, что нативная камера реагирует.
4. **Драйвер слайдера** поверх существующего BLE-сервиса + доработка протокола.
5. **Тележка** по документированному API.
6. Профили, UI, индикация.
7. Питание, замер батареи, корпус.
