10on/xiao-camera-remote/docs/design/Remote Screen.dc.html

Экран пульта · 280×240 · горизонтально · 1:1

# Экран съёмочного пульта

Все экраны в реальных пикселях панели: 280 в ширину, 240 в высоту, скруглённые углы корпуса. Ничего не масштабировано — если текст не читается здесь, он не прочитается и на железе.

УСТРОЙСТВО телефон слайдер тележка СОСТОЯНИЕ норма запись внимание

СЛАЙДЕР+ТЛФ 82%

ТЛТелефон ГОТОВ

СЛСлайдер ГОТОВ

ТЖТележка ГОТОВ

● ЗАПИСЬ · ↑↓ СЛАЙДЕР

Главный — норма

Экран покоя. Цветная плашка у каждого устройства, зелёный статус — все на связи.

СЛАЙДЕР+ТЛФ 79%

● ЗАПИСЬ 00:47 СЛАЙДЕР: ДВИЖЕНИЕ

● — СТОП

Идёт запись

Таймер — крупнейший элемент. Красная виньетка вместо мигания.

СЛАЙДЕР+ТЛФ 85%

ТЖ Тележка ⚠ НЕТ СВЯЗИ ↻ переподключение…

телефон, слайдер — ок

Потеря связи

Называет устройство его цветом и сообщает, что остальные в порядке.

ПРОФИЛИ

Слайдер+ТЛФ

Столик+ТЛФ

Интервью

↑↓ выбор · ● открыть

Выбор профиля

Три пункта в окне, выбранный — зелёная плашка.

БИНДИНГИ

Слайдер+телефон

Только слайдер

Только запись

↑↓ пресет · ● применить

Пресеты биндингов

Только выбор готовых схем — редактор живёт в веб-морде.

МЕНЮ

Профили

Яркость

OTA-обновление

↑↓ · ● · ◀ назад

Меню / настройки

Яркость правится на месте: ←→ шаг, ● подтвердить.

BLE: OFF WI-FI: ON

OTA РЕЖИМ 192.168.4.1 Ожидание подключения…

ФУНКЦИИ НЕДОСТУПНЫ

● — выход

OTA-режим

IP — самый крупный элемент: его набирают на ноутбуке. BLE выключен, функции пульта мертвы.
