10on/xiao-camera-remote/docs/design/ux-redesign-mock/current-screens.dc.html

Что прошивка рисует сейчас · 280×240 · 1:1

# Текущие экраны пульта

Снято с src/menu.cpp и src/theme.h: те же координаты, те же цвета RGB565, та же латинская подпись клавиш. Панель 240×280 используется горизонтально, углы скруглены, безопасный отступ у верхней и нижней строки — 28 px.

Ограничения железа, которые видны на всех макетах: Adafruit_GFX без градиентов (виньетка спеки заменена плоской полосой 3 px), встроенный шрифт 6×8 px для мелкой строки, кириллицы в шрифте нет — поэтому подписи латиницей.

Slider+Phone

82%

SL

Slider

READY

PH

Phone

DL

Dolly

OFF

OK:DEVICE RIGHT:CTRL HOLD-UP:MENU

Device List — стартовый экран

Каждое устройство включается вручную. Слева зелёная полоска 3 px — курсор выбора.

Slider+Phone

82%

SL

Slider

READY

PH

Phone

READY

DL

Dolly

OFF

OK:REC D-PAD:MOTION HOLD-L:BACK

Control — управление

Тот же список, другая подпись клавиш. Ни скорости, ни направления, ни позиции слайдера на экране нет.

Slider+Phone

79%

REC

00:47

MOTION

OK - STOP

Дубль (combo)

Появляется, когда активны телефон и моторное устройство: одно нажатие шлёт MoveForward + Record.

Slider+Phone

85%

DL

Dolly

NO LINK

RECONNECTING...

Slider, Phone OK

Потеря связи — перекрытие

Полноэкранное, глотает все кнопки кроме OK. Через 30 с строка меняется на FAILED - OK:RETRY.

MENU

PROFILES

BRIGHTNESS

OTA UPDATE

UP/DN OK:OPEN LEFT:BACK

Меню

Три пункта, выбранный — сплошная зелёная плашка (градиента у GFX нет).

PROFILES

Slider+Phone

Dolly

Dolly+Phone

UP/DN:SELECT OK:OPEN LEFT:BACK

Профили

Пять зашитых профилей, окно на три строки. Живут в глубине: Меню → Профили.

BINDINGS

Speed U/D

Speed L/R

Dolly

UP/DN:PRESET OK:APPLY LEFT:BACK

Биндинги

Выбранный пресет виден только здесь — на рабочем экране он нигде не подписан.

BRIGHTNESS

75

L/R:ADJUST OK:SAVE HOLD-L:CANCEL

Яркость

Правится на месте, подсветка меняется сразу; отмена возвращает сохранённое значение.

BLE: OFF

WIFI: ON

OTA MODE

192.168.1.42

Waiting for connection...

FUNCTIONS DISABLED

OK - EXIT

OTA

Реальный IP из сети, а не 192.168.4.1 из мокапа: пульт подключается к сети, а не поднимает точку.
