10on/xiao-camera-remote/docs/design/ux-redesign-mock/new-model.dc.html

Новая UX-модель · 280×240 · 1:1

# Пульт: съёмочные конфигурации вместо списка устройств

Экраны нарисованы в пикселях панели и в существующей палитре прошивки (src/theme.h): плоские заливки, скруглённые плашки, полоса состояния 3 px вместо виньетки, мелкая строка — моноширинная сетка 6×8 px. Ничего, что Adafruit_GFX не нарисует.

Два ограничения, которые держат вёрстку: мелкая строка — максимум 37 знаков между скруглёнными углами (28 px безопасный отступ), кириллица требует сгенерировать GFXfont — сейчас в прошивке её нет.

MAIN слайдер тележка SECONDARY телефоны столик (в планах) СОСТОЯНИЕ готов дубль внимание

ИКОНКИ · 26×26 · ТОЛЬКО ПРЯМОУГОЛЬНИКИ И КРУГИ телефон слайдер: рельс и каретка тележка: корпус и колёса столик: диск и предмет

§5–6 · Старт

## Выбрал риг → дождался → снимаю

КОНФИГУРАЦИИ

82%

Слайдер + телефонПОСЛЕДНЯЯ

СЛАЙДЕР · ТЛФ ДЕНИСА

Тележка + телефон

ТЕЛЕЖКА · ТЛФ ДЕНИСА

Два телефона

БЕЗ MAIN · ТЛФ A + ТЛФ B

1/5 · ↑↓ ВЫБОР

OK ПОДКЛЮЧИТЬ · → ИЗМЕНИТЬ

УДЕРЖАТЬ ← УСТРОЙСТВА

1 · Конфигурации — домашний экран

Последняя использованная выбрана заранее: включил пульт, нажал OK — риг поднимается сам. Состав набора виден строкой, а не догадкой.

ЗАПУСК: СЛАЙДЕР + ТЛФ

82%

ГЛАВНОЕ

Слайдер ПОДКЛЮЧАЮ

ВСПОМОГАТЕЛЬНЫЕ

Телефон Дениса ИЩУ

ОТКРОЮ УПРАВЛЕНИЕ, КОГДА MAIN ГОТОВ

УДЕРЖАТЬ ← ОТМЕНА

2 · Подключение

Тот же набор, теперь как статус. Main отделён рамкой и словом «Главное»; телефон догоняет в фоне и не задерживает переход.

ЗАПУСК: СЛАЙДЕР + ТЛФ

82%

НЕТ ОТВЕТА

Слайдер НЕТ СВЯЗИ

Телефон Дениса НЕТ СВЯЗИ

ПРОВЕРЬТЕ ПИТАНИЕ УСТРОЙСТВ

OK ПОВТОРИТЬ

УДЕРЖАТЬ ← ОТМЕНА

3 · Никто не поднялся

Экран остаётся статусом запуска: видно, кто именно молчит, и есть ровно два действия — повторить или отменить сессию.

§7–8 · Управление и дубль

## Экран строится вокруг Main, запись — компактный блок внизу

СЛАЙДЕР + ТЛФ

ТЛ 1/182%

Слайдер СТОИТ

СКОРОСТЬ

4

/8

ХОД

◀ ▶ ДОМ

↑↓ СКОРОСТЬ · ←→ ХОД · УДЕРЖ → ДОМОЙ

OK — ЗАПИСЬ 1 КАМЕРА

УДЕРЖАТЬ OK — АВАРИЙНЫЙ СТОП

4 · Slider — всё готово

Скорость, ход, дом и биндинг осей подписаны прямо на экране. OK обещает только запись — движение остаётся на стрелках.

СЛАЙДЕР + ТЛФ

ТЛ 0/180%

Слайдер ЕДЕТ ▶

СКОРОСТЬ

6

/8

ХОД

◀ ▶ ДОМ

↑↓ СКОРОСТЬ · ←→ ХОД · УДЕРЖ → ДОМОЙ

ЗАПИСЬ НЕДОСТУПНА ТЛФ ДЕНИСА — НЕТ СВЯЗИ, ИЩУ

УДЕРЖАТЬ OK — АВАРИЙНЫЙ СТОП

5 · Main работает, телефона нет

Слайдер полностью управляем, блок записи честно погашен и назван по имени. Никакого полноэкранного блока.

СЛАЙДЕР + ТЛФ

79%

00:47 ● ЗАПИСЬ2/2 КАМЕРЫ

Слайдер ЕДЕТ ▶ 4/8

↑↓ СКОРОСТЬ · ←→ ХОД

OK — СТОП ЗАПИСИ

УДЕРЖАТЬ OK — СТОП ВСЕГО

6 · Идёт дубль

Таймер и число камер — крупным блоком, но управление слайдером остаётся на экране: стрелки не перестают работать.

ДВА ТЕЛЕФОНА + СЛАЙДЕР

76%

01:12 ● ЗАПИСЬ1/2 КАМЕРЫ

⚠ Телефон B — нет связи

ТЛФ A ПИШЕТ · ПЕРЕПОДКЛЮЧАЮ B

Слайдер ЕДЕТ ▶ 4/8

OK — СТОП ЗАПИСИ

УДЕРЖАТЬ OK — СТОП ВСЕГО

7 · Одна камера из двух потеряна

Заметная жёлтая полоса, но дубль не прерывается и экран не блокируется. Счётчик камер сразу показывает 1/2.

ТЕЛЕЖКА + ТЛФ

ТЛ 1/164%

Тележка СТОИТ

СКОРОСТЬ

2

/8

ХОД

◀ ▶

←→ СКОРОСТЬ · ↑↓ ХОД

OK — ЗАПИСЬ 1 КАМЕРА

УДЕРЖАТЬ OK — E-STOP

8 · Dolly

Тот же каркас, свой набор команд: нет «Дома», зато подписан E-Stop. Здесь показан биндинг «скорость на ←→».

ДВА ТЕЛЕФОНА

91%

Телефон A ГОТОВ

Телефон B ГОТОВ

OK — ЗАПИСЬ

СТАРТ УЙДЁТ ОБЕИМ КАМЕРАМ

УДЕРЖАТЬ ← К КОНФИГУРАЦИЯМ

9 · Набор без Main

Только камеры и одно действие. Пустого «экрана устройства» нет — весь экран отдан кнопке записи.

СЛАЙДЕР + ТЛФ

78%

Слайдер потерян

ДВИЖЕНИЕ ОСТАНОВЛЕНО

ЗАПИСЬ ОСТАНОВЛЕНА НА ВСЕХ КАМЕРАХ

ТЛФ ДЕНИСА НА СВЯЗИ

OK ПЕРЕПОДКЛЮЧИТЬ

УДЕРЖАТЬ ← К КОНФИГУРАЦИЯМ

10 · Main потерян

Единственный случай полноэкранного перекрытия. Экран сообщает не только о потере, но и о том, что аварийная остановка уже отправлена.

§9, §11 · Редактор и настройки

## Редко используемое — глубже, но не потеряно

ИЗМЕНИТЬ · ШАГ 2/4

СЛАЙДЕР + ТЛФ

Главное устройство

Слайдер

Тележка

Нет

MAIN ТОЛЬКО ОДИН

OK ДАЛЬШЕ · УДЕРЖАТЬ ← НАЗАД

11 · Редактор: Main

Шаг за шагом, четыре экрана: название, Main, Secondary, поведение дубля.

ИЗМЕНИТЬ · ШАГ 3/4

MAIN: СЛАЙДЕР

Вспомогательные

✓ Телефон Дениса

Телефон B

Тележка УЖЕ MAIN

ТЕЛЕФОНОВ МОЖНО НЕСКОЛЬКО

→ ОТМЕТИТЬ · OK ДАЛЬШЕ

12 · Редактор: Secondary

Чекбоксы, а не порядок строк. Устройство, уже занятое ролью Main, показано, но недоступно.

ИЗМЕНИТЬ · ШАГ 4/4

MAIN: СЛАЙДЕР

Поведение дубля

Запись

OK ТОЛЬКО КАМЕРЫ · ХОД НА СТРЕЛКАХ

Запись + движение

OK ПИШЕТ И ЗАПУСКАЕТ СЛАЙДЕР

РЕЖИМ ПОДПИСАН НА РАБОЧЕМ ЭКРАНЕ

OK СОХРАНИТЬ · УДЕРЖАТЬ ← НАЗАД

13 · Редактор: поведение дубля

Замена старого неявного комбо: режим выбирается явно и по умолчанию — «Запись».

НАСТРОЙКИ

1/5

Конфигурации

Устройства

Управление

Экран

↑↓ · OK ОТКРЫТЬ · ← НАЗАД

14 · Настройки

Пять разделов; пятый — «Система» с OTA и версией прошивки. Яркость живёт в «Экране».

УСТРОЙСТВА

4 ШТ

СлайдерMOTION · СЕГОДНЯ 14:02

Телефон ДенисаCAMERA · СЕГОДНЯ 14:02

ТележкаMOTION · 12 АВГ

→ ПЕРЕИМЕНОВАТЬ, УДАЛИТЬ, ПРОВЕРИТЬ

OK ДОБАВИТЬ · ← НАЗАД

15 · Устройства (реестр)

Бывший Device List: тип, понятное имя, время последнего соединения. Экран настройки и диагностики, а не ежедневный старт.

Остальные экраны

## Списки, пустые состояния, вложенные разделы

КОНФИГУРАЦИИ

82%

Тележка

БЕЗ ЗАПИСИ · РУЧНОЙ ХОД

Столик + телефон4/5

СТОЛИК · ТЛФ ДЕНИСА

Два телефона

БЕЗ MAIN · ТЛФ A + ТЛФ B

4/5 · ↑↓ ВЫБОР

OK ПОДКЛЮЧИТЬ · → ИЗМЕНИТЬ

УДЕРЖАТЬ ← УСТРОЙСТВА

16 · Конфигурации, прокрутка

Окно на три строки, полоса прокрутки справа. Наборы без Main и без телефона живут в том же списке.

КОНФИГУРАЦИИ

96%

Наборов пока нет

СОБЕРИТЕ ПЕРВЫЙ ИЗ УСТРОЙСТВ

OK СОЗДАТЬ НАБОР

УДЕРЖАТЬ ← УСТРОЙСТВА

17 · Пустой список

Первое включение или всё удалено: единственное осмысленное действие вынесено на OK.

СЛАЙДЕР + ТЕЛЕФОН

НАБОР

Изменить

Дублировать

Переименовать

Удалить

OK ВЫБРАТЬ · ← НАЗАД К СПИСКУ

18 · Меню набора (→)

Правая стрелка со стартового экрана. Удаление отмечено красным и спросит подтверждение.

ИЗМЕНИТЬ · ШАГ 1/4

НАЗВАНИЕ

Как называется набор

СЛАЙДЕР+ТЛФ

AБВГДЕЖЗИКЛМ

↑↓ БУКВА · ←→ ПОЗИЦИЯ · УДЕРЖ → СТЕРЕТЬ

OK ДАЛЬШЕ · УДЕРЖАТЬ ← ОТМЕНА

19 · Редактор: название

Ввод пятью кнопками: курсор-блок в строке, лента букв под ней. Медленно, но нужно один раз.

ПОИСК УСТРОЙСТВ

ИЩУ…

Dolly_02MOTION · −54 dBm

Turntable_AMOTION · −71 dBm

ТЕЛЕФОН ДОБАВЛЯЕТСЯ СО СТОРОНЫ ТЕЛЕФОНА

OK ДОБАВИТЬ В РЕЕСТР

← НАЗАД К УСТРОЙСТВАМ

20 · Поиск новых устройств

Единственное место, где пульт сканирует эфир целиком. В остальное время он подключает только участников набора.

УСТРОЙСТВО

НА СВЯЗИ

Телефон ДенисаCAMERA · BLE HID

IDA4:C1:38:9E:12:07

ПОСЛЕДНЕЕ СОЕДИНЕНИЕСЕГОДНЯ 14:02

В НАБОРАХ3

Проверить связь

Переименовать

↑↓ · OK ВЫПОЛНИТЬ · ← НАЗАД

21 · Карточка устройства

Тип, идентификатор, время последнего соединения и число наборов, где оно участвует — чтобы удаление не было сюрпризом.

УПРАВЛЕНИЕ

Оси

СКОРОСТЬ НА ↑↓ · ХОД НА ←→

Максимальная скорость6/8

Автозапуск последнейВЫКЛ

Звук кнопокВКЛ

↑↓ ПУНКТ · ←→ ЗНАЧЕНИЕ · ← НАЗАД

22 · Управление

Биндинг осей задаётся здесь, а подписывается на рабочем экране — выбранный режим никогда не остаётся невидимым.

СИСТЕМА

Прошивка1.4.2

Батарея82% · 3.98 В

OTA-обновление

Сброс настроек

OTA ОТКЛЮЧАЕТ BLE НА ВРЕМЯ ОБНОВЛЕНИЯ

OK ОТКРЫТЬ · ← НАЗАД

23 · Система

OTA остаётся на месте, но уходит на пятый уровень и предупреждает о цене входа.

СТОЛИК + ТЛФ

ТЛ 1/188%

Столик КРУТИТСЯ

ОБОРОТ

60

СЕК

НАПРАВЛЕНИЕ

↻ ↺

↑↓ СКОРОСТЬ · ←→ НАПРАВЛЕНИЕ

OK — ЗАПИСЬ 1 КАМЕРА

УДЕРЖАТЬ OK — СТОП ВСЕГО

24 · Предметный столик (задел)

Тот же каркас Main: параметр столика — время оборота, а не скорость хода. Оранжевый оттенок близок к «внимание» — если столик дойдёт до железа, цвет стоит развести.

§10, §12 · Сверка

## Кнопки по экранам и обязательные состояния

ЭКРАН

СТРЕЛКИ

OK

УДЕРЖАНИЕ

Конфигурации

↑↓ выбор · → меню набора

запустить

← устройства и настройки

Подключение

—

повторить

← отменить сессию

Slider / Dolly / Столик

ход и скорость по показанному биндингу

REC / STOP REC

OK — E-Stop и стоп записи · ← к конфигурациям

Только камеры

—

REC / STOP REC

OK — стоп записи · ← к конфигурациям

Редактор

↑↓ поле · ←→ значение

подтвердить

← назад без сохранения

8 ОБЯЗАТЕЛЬНЫХ СОСТОЯНИЙ §12

1Набор выбран, но не запущенэкран 1

2Идёт подключение участника2, 3

3Main готов, Secondary догоняют2

4Main работает, записи нет5

5Идёт дубль6

6Один телефон из нескольких потерян7

7Main потерян или аварийно остановлен10

8Набор без Main: только камеры9

Открытый вопрос к железу: время оборота столика и телеметрия слайдера (позиция, заряд) должны прийти от устройств — сейчас на экранах показаны как макетные значения.
