10on/xiao-camera-remote/hardware/xiao_remote.png

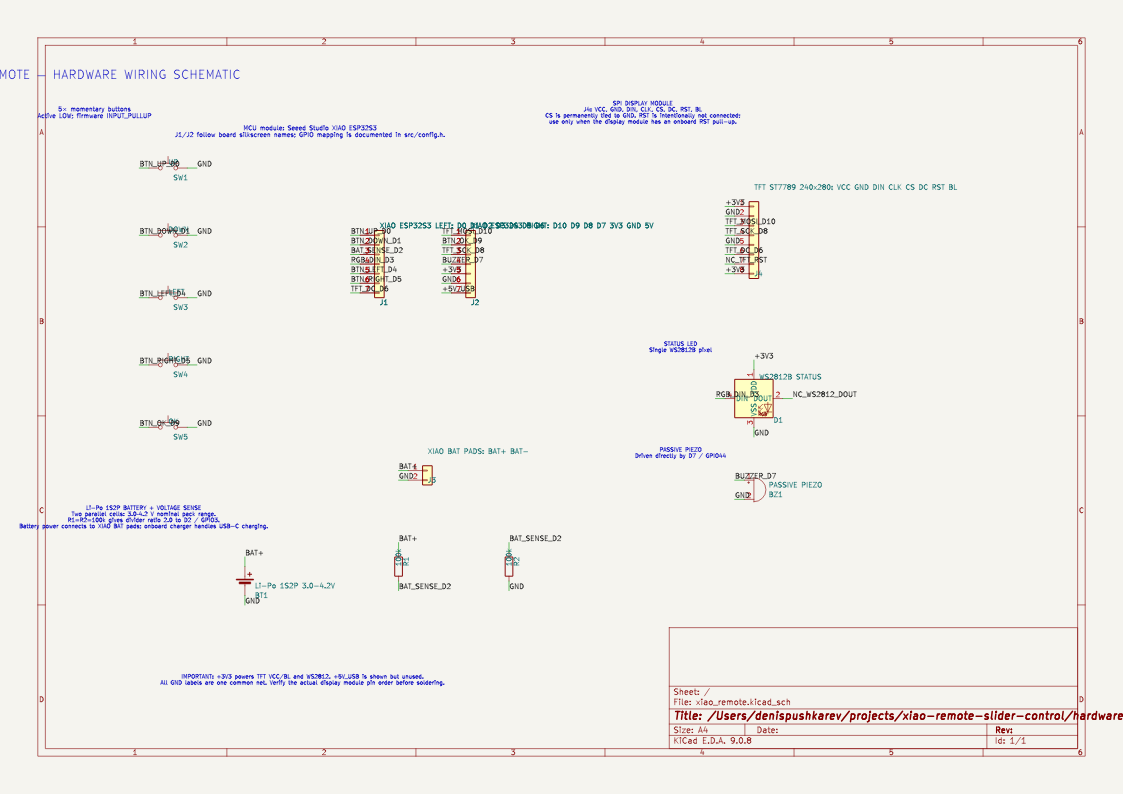
hardware/xiao_remote.png
