10on/xiao-camera-remote/hardware/xiao_remote.kicad_sch

## KiCad design hardware/xiao_remote.kicad_sch (2026-08-27)

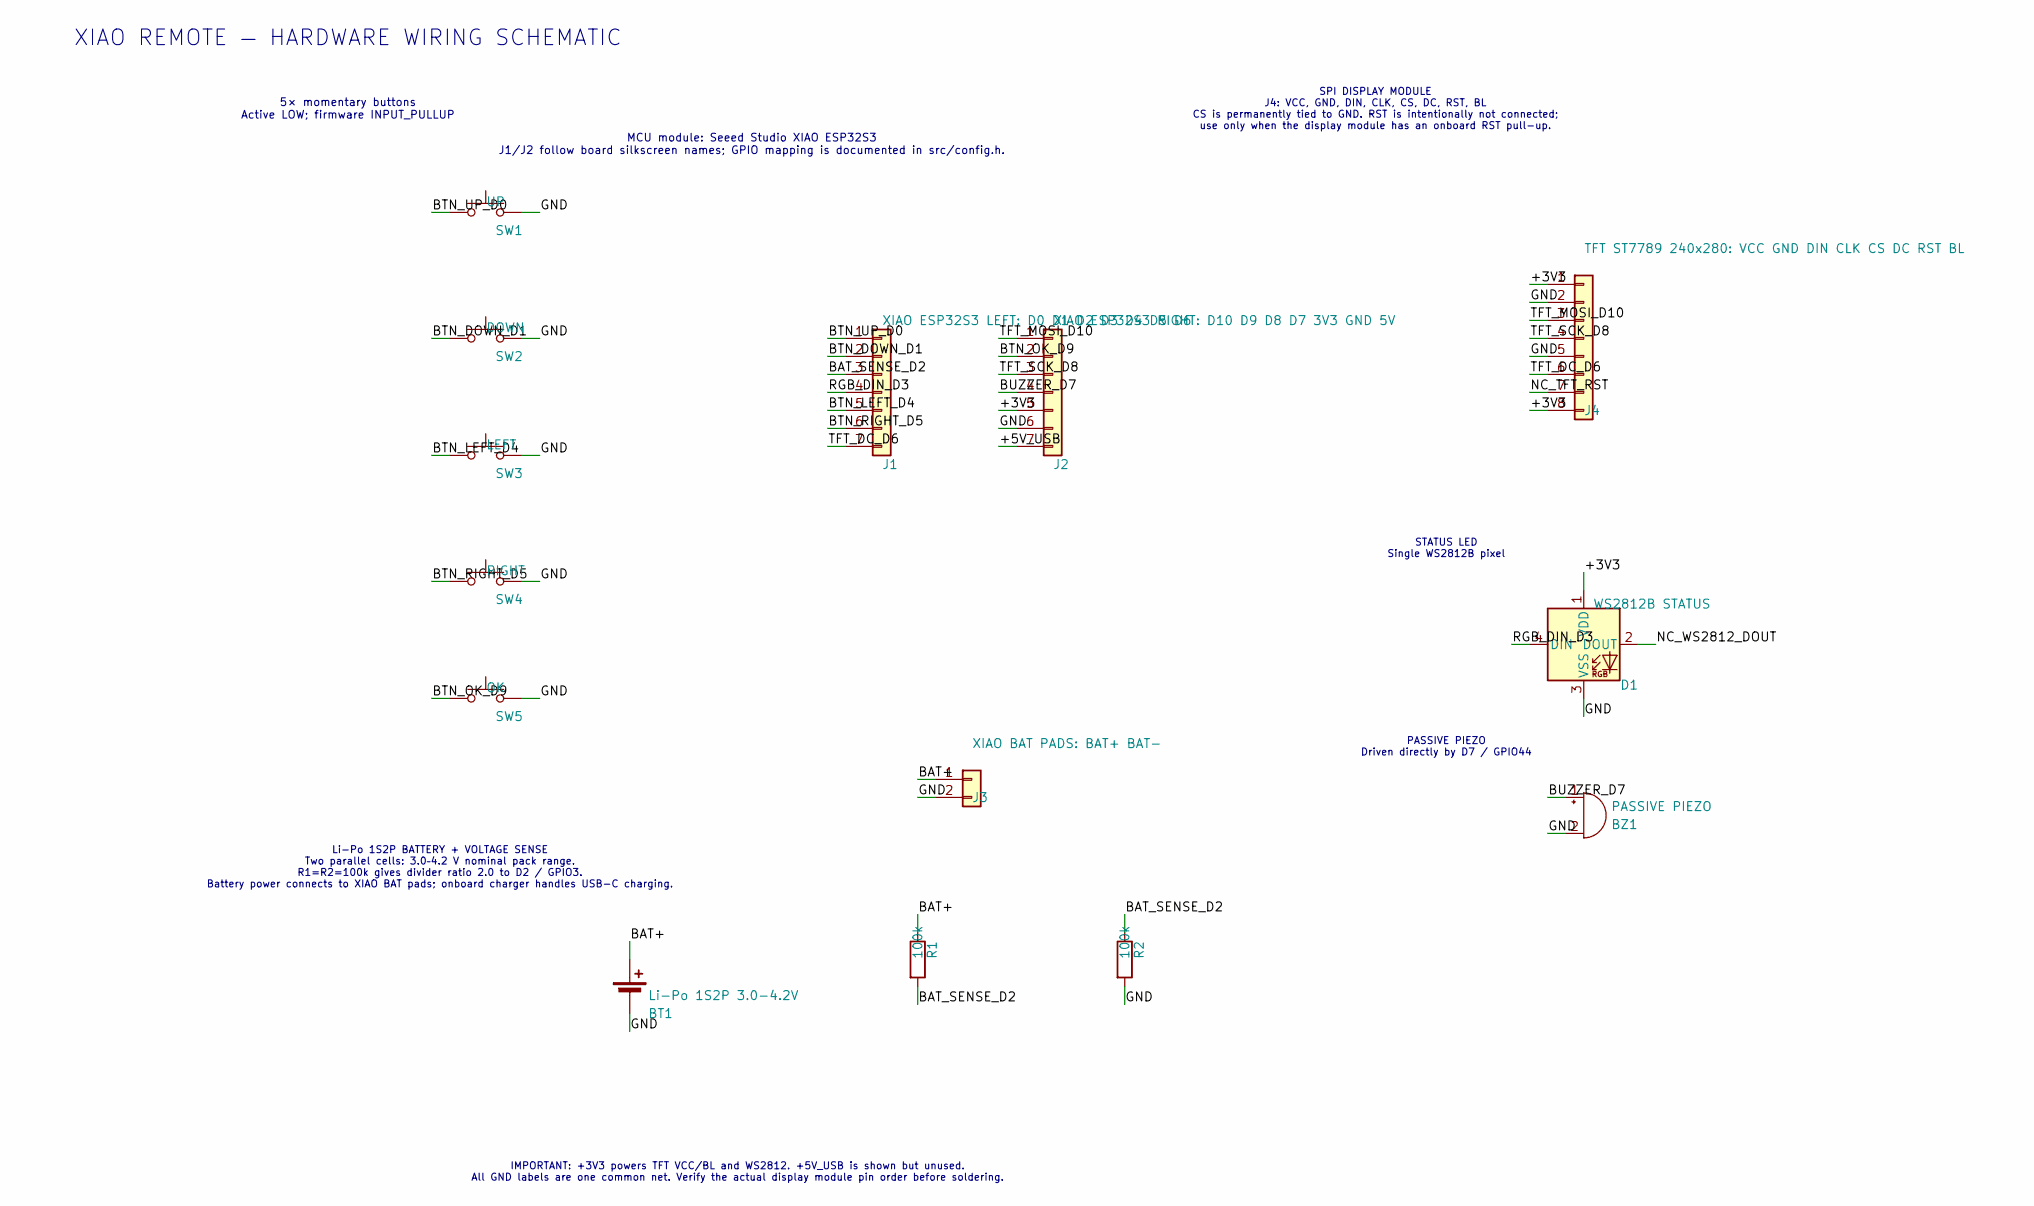
[picture p2: schematic xiao_remote.kicad_sch]

Parts:
BT1: Li-Po 1S2P 3.0-4.2V
BZ1: PASSIVE PIEZO
D1: WS2812B STATUS
J1: XIAO ESP32S3 LEFT: D0 D1 D2 D3 D4 D5 D6
J2: XIAO ESP32S3 RIGHT: D10 D9 D8 D7 3V3 GND 5V
J3: XIAO BAT PADS: BAT+ BAT-
J4: TFT ST7789 240x280: VCC GND DIN CLK CS DC RST BL
R1, R2: 100k
SW1: UP
SW2: DOWN
SW3: LEFT
SW4: RIGHT
SW5: OK

Connections:
+3V3: D1.1 (VDD), J2.5, J4.1, J4.8
+5V_USB: J2.7
BAT+: BT1.1 (+), J3.1, R1.1
BAT_SENSE_D2: J1.3, R1.2, R2.1
BTN_DOWN_D1: J1.2, SW2.1
BTN_LEFT_D4: J1.5, SW3.1
BTN_OK_D9: J2.2, SW5.1
BTN_RIGHT_D5: J1.6, SW4.1
BTN_UP_D0: J1.1, SW1.1
BUZZER_D7: BZ1.1 (+), J2.4
GND: BT1.2 (-), BZ1.2 (-), D1.3 (VSS), J2.6, J3.2, J4.2, J4.5, R2.2, SW1.2, SW2.2, SW3.2, SW4.2, SW5.2
NC_TFT_RST: J4.7
NC_WS2812_DOUT: D1.2 (DOUT)
RGB_DIN_D3: D1.4 (DIN), J1.4
TFT_DC_D6: J1.7, J4.6
TFT_MOSI_D10: J2.1, J4.3
TFT_SCK_D8: J2.3, J4.4

Notes on the sheet:
XIAO REMOTE — HARDWARE WIRING SCHEMATIC
MCU module: Seeed Studio XIAO ESP32S3 J1/J2 follow board silkscreen names; GPIO mapping is documented in src/config.h.
5× momentary buttons Active LOW; firmware INPUT_PULLUP
SPI DISPLAY MODULE J4: VCC, GND, DIN, CLK, CS, DC, RST, BL CS is permanently tied to GND. RST is intentionally not connected; use only when the display module has an onboard RST pull-up.
STATUS LED Single WS2812B pixel
PASSIVE PIEZO Driven directly by D7 / GPIO44
Li-Po 1S2P BATTERY + VOLTAGE SENSE Two parallel cells: 3.0–4.2 V nominal pack range. R1=R2=100k gives divider ratio 2.0 to D2 / GPIO3. Battery power connects to XIAO BAT pads; onboard charger handles USB-C charging.
IMPORTANT: +3V3 powers TFT VCC/BL and WS2812. +5V_USB is shown but unused. All GND labels are one common net. Verify the actual display module pin order before soldering.
