10on/xiao-camera-remote/src/ble_manager.h

#pragma once

#include <NimBLEDevice.h>
#include "devices/device.h"

// Owns the single BLE central scan shared by every device driver — NimBLE
// only supports one active scan at a time, so individual Device instances
// don't scan themselves. Devices register once at startup; Device::
// activate()/deactivate() just flips a want-connection flag on the
// device, and this manager (re)scans/(re)connects for every
// active-but-disconnected device, stopping once all active devices are
// connected and resuming automatically if one drops.
class BleManager : public NimBLEScanCallbacks {
public:
	void begin();
	void registerDevice(Device *dev);
	void update();

	void onResult(const NimBLEAdvertisedDevice *advertisedDevice) override;
	void onScanEnd(const NimBLEScanResults &results, int reason) override;

private:
	bool anyDeviceWaiting() const;
	void ensureScanning();

	static const size_t kMaxDevices = 6;
	Device *_devices[kMaxDevices] = {};
	size_t _deviceCount = 0;

	// A match found by onResult() is connected from the *next* update()
	// tick, not synchronously inside onResult() itself. onResult() runs
	// on the NimBLE host task as part of the scan's own event processing;
	// Device::beginGattConnection() calls a blocking NimBLEClient::connect(),
	// and starting a new GAP connection procedure from inside that same
	// scan-callback stack can deadlock — the connect needs the host task
	// to keep processing events, but the host task is the one blocked
	// inside connect() (see NimBLEClient::startConnectionAttempt()'s own
	// BLE_HS_EBUSY handling, which exists for exactly this scan-vs-connect
	// collision). update() runs from the Arduino main loop instead, a
	// clean call stack with the scan already fully stopped.
	Device *_pendingConnectDevice = nullptr;
	const NimBLEAdvertisedDevice *_pendingConnectAdvertised = nullptr;
};

extern BleManager bleManager;
