10on/xiao-camera-remote/(commit log)

2026-08-27 Initial hardware bring-up: display, buttons, battery, BLE, OTA
    PCF8575 I/O expander for buttons/LEDs, ST7789-driven TFT panel,
    battery ADC monitoring, buzzer, NimBLE central connection to the
    slider, WiFi OTA update flow, and a first-pass device-list/control
    menu.
    Claude-Session: https://claude.ai/code/session_01K7H63FFY9tuyUYcdgCuGyT
    [battery.cpp, battery.h, ble_manager.cpp, ble_manager.h, buttons.cpp, buttons.h, buzzer.cpp, buzzer.h]
2026-08-27 Rewrite pin map for PCF8575 port expander, deep sleep, confirmed wiring
    Buttons and status LEDs move onto the PCF8575 I/O expander (freeing
    GPIOs), driven by a real interrupt instead of polling. Ok stays on a
    dedicated RTC-capable GPIO since it's the deep-sleep wake source.
    Battery ADC moves off the non-ADC-capable GPIO44 it started on. Status
    LED yellow/blue channels swapped to match how they're actually wired
    on the board. Adds deep-sleep timing constants (IDLE_DEEPSLEEP_MS,
    DAILY_CHECK_SEC, BATT_CRITICAL_PCT).
    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
    [xiao_remote.kicad_sch]
2026-08-27 Fix display: NV3030B tuning, backlight PWM, deep-sleep hold, tearing
    - Real NV3030B init sequence (gamma/VCOM/pump/porch registers) instead
    of relying on the generic ST7789 init's power-on defaults, which
    this panel doesn't have OTP-trimmed — fixes a washed-out/foggy
    picture.
    - Backlight now driven via analogWrite()/LEDC (settings-persisted
    brightness) instead of a flat digitalWrite(HIGH), with a Brightness
    menu item to adjust it live.
    - Deep sleep: the backlight GPIO is latched via the RTC domain
    (rtc_gpio_hold_en/_deinit) so it actually stays off for the whole
    sleep and reliably comes back on wake — plain digitalWrite() only
    holds through the regular GPIO matrix, which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
    [display.cpp, display.h, main.cpp, settings.cpp, settings.h, test_color_bars.cpp]
2026-08-27 Fix BLE central connect deadlock (blocking connect() from scan callback)
    BleManager::onResult() called Device::beginGattConnection() — which
    does a blocking NimBLEClient::connect() — synchronously from inside
    the scan-result callback, itself running on the NimBLE host task.
    Starting a new GAP connection procedure from that same call stack can
    deadlock: connect() needs the host task to keep processing events,
    but the host task is the one blocked inside connect(). (NimBLEClient's
    own startConnectionAttempt() has BLE_HS_EBUSY handling for exactly
    this scan-vs-connect collision.) Symptom: a device stayed stuck on
    "connecting..." forever once a scan was in flight when the match was
    found —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
    [ble_manager.cpp, ble_manager.h, slider_device.cpp, slider_device.h]
2026-08-27 Add Profile/Binding/Settings menu, connection-lost takeover, combo start/stop
    - Profile (which devices to activate together) and BindingPreset
    (D-pad -> Command mapping) data model, persisted selection via NVS
    (settings.h from the previous commit).
    - Settings screen becomes a real 3-item menu (Profiles/Brightness/OTA)
    with an inline brightness adjuster and an OTA-start confirm step,
    plus new Profile-select and Binding-presets list screens.
    - Connection-lost full-screen takeover when a device that was actually
    connected drops its link (not just still on its first connection
    attempt — that's the DeviceList/Control screens' own "connecting…"
    pill, not a takeover).
    - Control sc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
    [command.h, device.h, menu.cpp, menu.h, theme.h]
2026-08-27 Add phone BLE HID driver and dolly driver, custom fonts, Recording screen
    Phone: presents as a BLE HID peripheral (Consumer Control) so a phone
    can pair with the remote like a Bluetooth camera shutter — the
    inverse role from the slider/dolly, which the remote connects to as
    a central. Starting its GATT server stops any in-flight central scan
    first (see the BLE deadlock fix) since running both concurrently
    crashes NimBLE's GAP service init.
    Dolly: BLE motion driver alongside the slider, with its own dedicated
    EmergencyStop handling.
    Menu gets custom GFX fonts (FreeSans/FreeMono, replacing the built-in
    6x8 bitmap font) and a Recording screen with a live count-up timer,
    shown automatically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
    [dolly_device.cpp, dolly_device.h, phone_device.cpp, phone_device.h]
2026-08-27 Add minimal hello/PCF8575 bring-up test sketches
    Standalone platformio.ini envs (hello_test, pcf_test) for isolating
    basic Serial output and I2C/PCF8575 ACK issues from the rest of the
    firmware during hardware bring-up.
    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
    [test_hello.cpp, test_pcf8575.cpp]
2026-08-27 Rework on-device UX: shooting-rig model + full 24-screen redesign
    Authoritative spec: docs/design/ux-redesign.md + the pixel mock in
    docs/design/ux-redesign-mock/ (built from real shooting experience;
    supersedes the handoff's 7-screen list and requirements-v14 §3 "Профили").
    Copy is English placeholder — a Cyrillic GFXfont is a separate follow-up.
    Data model
    - src/profile.{h,cpp} -> src/rig.{h,cpp}: Rig = { name, mainIndex,
    secondary[4], takeMode }, mutable. src/rig_store.* = versioned NVS blob
    with CRUD for the editor, seeds the §5 defaults.
    - src/device_table.* = stable deviceAt/deviceCount/deviceIndexOf identity
    that rigs reference. src/device_registry.* = per-device ali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
    [command.h, device.h, device_registry.cpp, device_registry.h, device_table.cpp, device_table.h, dolly_device.cpp, dolly_device.h]
2026-08-27 Multi-phone support + two-stage idle sleep
    Multiple phones
    - PhoneDevice is multi-peer: the one phone slot holds up to kMaxPhones (3)
    bonded phones connected at once. _consumerInput->notify() fans a shutter
    report to every subscribed phone in one call, so REC / STOP REC hit them
    all.
    - Device::cameraReady()/cameraTotal() feed the CAM n/m counts;
    markTakeStart() holds total at the take's peak so a phone dropping
    mid-take reads "1/2". rigPhoneCounts() sums those.
    - platformio.ini: CONFIG_BT_NIMBLE_MAX_CONNECTIONS=4 (slider + dolly + 2
    phones), MAX_BONDS=4. The old single-peer quick-switch is removed.
    - Cameras-only screen: one row per connected phone + a LINKING row while
    waiting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
2026-08-27 Simplify motion control screen + fix dolly speed
    Control screen
    - One fixed arrow mapping for every motion Main: up/down = speed, left/
    right = drive that direction (same key again or Ok = stop, opposite =
    reverse). Removed the axis-binding setting and its ControlPrefs row.
    - Slider uses the same arrows for manual jog; Ok is the Ping-Pong
    program's START/STOP when there's no phone to record.
    - renderControlMotion stripped: plain state word (STOPPED/FWD/BACK/RUNNING/
    HOMING/ERROR, no protocol jargon), one big speed numeral, one big
    direction arrow (pause bars when stopped), speed bar, one action block,
    one footer line. Dropped E1/E2 dots, the program-name row, the SPEED/
    TRAVEL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
    [dolly_device.cpp, dolly_device.h, menu.cpp, menu_render.cpp, settings.cpp, settings.h]
2026-08-28 Add Turntable BLE device driver
    Central client for the ali-turn-table-upgrade peripheral (service
    7ab1e001-…-cafe): Command char F/B/S/R, Speed char (preset index),
    notifying 6-byte Status. Registered as device index 3.
    - devices/turntable_device.{h,cpp}
    - device_table: append &turntableDevice (index 3)
    - device_registry: 3 -> kMaxDevices(4), add "a3" alias key
    - theme: kTurntableFill/Text (teal identity)
2026-08-28 Turntable rigs, per-device L/R flip, OTA no-wifi state, scan debug
    - Turntable: two seed rigs (Turntable + Phone, Turntable), rig_store
    layout -> v3 (reseed). matchesAdvertisement now also matches the service
    UUID (in the primary adv packet), not just the name (scan response only).
    - Per-device "Flip L/R" toggle in the device card (DeviceRegistry, NVS):
    a motion protocol's F/B is motor-relative, so which way "->" drives
    depends on how the device is placed. Menu swaps MoveForward/MoveBackward
    when set.
    - Control screen state word now trusts device telemetry
    (motionStateText/programRunning) over the locally-tracked jog state, so
    a turntable/slider started from its own buttons rea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
    [ble_manager.cpp, ble_manager.h, device_registry.cpp, device_registry.h, menu.cpp, menu_render.cpp, ota.cpp, ota.h]
2026-08-28 OTA upload progress bar
    The multipart firmware upload is handled synchronously inside
    WebServer::handleClient(), so the main loop can't redraw during it.
    Ota now:
    - reads Content-Length (via collectHeaders) at UPLOAD_FILE_START for a total
    - tracks bytes written, computes a 0..100 % (clamped — the count includes
    the small multipart wrapper)
    - fires a ProgressFn per percent step; main.cpp wires it to
    menu.renderOtaProgress() so the OTA screen repaints a % + bar mid-transfer
    A wire flash (pio run -t upload) can't show a bar — the firmware isn't
    running, the chip is in the ROM bootloader; progress is esptool's terminal %.
    Claude-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
2026-08-28 Slider speed: drive the slider's native 1..100% instead of a local 1..8 scale
    The remote had invented an 8-step speed scale on top of the slider's
    native 1..100% (cfg.speed). Two problems fell out of that:
    - Lossy double quantization: slider at 50% -> remote shows level 4 ->
    first nudge sends 43% or 57%, skipping the value it was actually on.
    - The slider notifies cfg.speed at 10 Hz; onProgramNotify re-derived the
    level from it every tick, so it stomped the optimistic local level
    before a CONFIGURE round-tripped and the numeral bounced / snapped back.
    - The legacy Speed-characteristic fallback stepped the interval linearly
    (5000 - n*4900/7), but the slider decodes that interval geo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
    [device.h, dolly_device.cpp, dolly_device.h, menu.cpp, menu_render.cpp, settings.cpp, settings.h, slider_device.cpp]
